ThomasVDD/SmartSoldering/Kicad_Tweezers/Dimensions.JPG

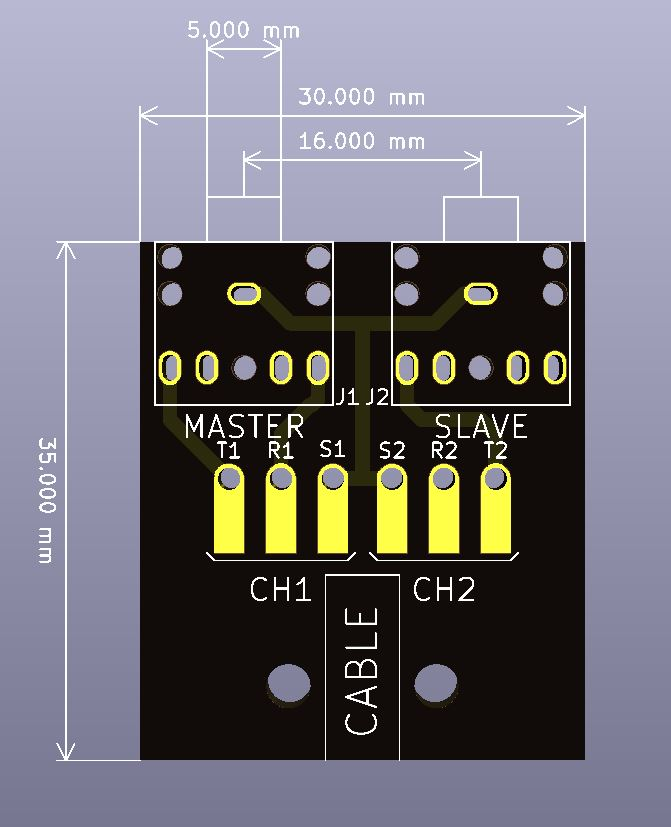
Kicad_Tweezers/Dimensions.JPG
