ThomasVDD/SmartSoldering/README.md

# SmartSoldering
SmartSoldering - Weller compatible soldering station
