ThomasVDD/SmartSoldering/Kicad/BOM.xlsx

Sheet: SolderingRT1Excell
Designator | Package | Quantity | Designation | manufacturer ref | farnell ref | digikey ref
J4 | PinHeader_1x08_P2.54mm_Vertical | 1 | Conn_01x08_Female |  |  | 2057-RS1-08-G-ND
SW4a1 | SW_Toggle_Blue_wSlots | 1 | SW_SPDT | ANT11SECQE |  | 2449-ANT11SECQE-ND
M2b1,QM4b1 | SOIC-8_3.9x4.9mm_P1.27mm | 2 | AO3400A | AOSP36326C |  | 785-AOSP36326CCT-ND
J1b1,J2b1 | Jack_3.5mm_CUI_SJ-3523-SMT_Horizontal | 2 | AudioJack3 | SJ-3523-SMT-TR |  | CP-3523SJCT-ND
J1b2,J2b2 | audio jack vertical | 2 | AudioJack3 | 0472570001 |  | WM17366-ND
U1c1 | TQFP-44_10x10mm_P0.8mm | 1 | ATmega32U4-AU | ATmega32U4-AU |  | ATMEGA32U4-AU-ND
C9a1,C14a1 | CP_Elec_8x10.5 | 2 | 330uF | EEE-1EA331UP |  | EEE-1EA331UP
Y1c1 | Crystal_SMD_3225-4Pin_3.2x2.5mm | 1 | 16MHz | TSX-3225 16.0000MF09Z-AC0 |  | SER4069CT-ND
U2a1 | SOT-89-3 | 1 | L78L05_SOT89 | L78L05ABUTR |  | 497-1181-1-ND
U1b1 | SOIC-8_3.9x4.9mm_P1.27mm | 1 | OPA2335 | OPA2335AIDR |  | 296-13462-1-ND
SW3a1,SW2a1 | SW_Push_1P1T_NO_6x6mm_H9.5mm | 2 | SW_Push | PTS645SK95SMTR92LFS |  | CKN10819CT-ND
SW1a1 | RotaryEncoder_Alps_EC11E-Switch_Vertical_H20mm | 1 | Rotary_Encoder_Switch | PEC11L-4115F-S0020 |  | PEC11L-4115F-S0020-ND
R9b1,R6a1,R3c1,R3a1,R2a1,R1a1,R18b1,R17a1,R13a1,R12a1,R11a1 | R_0603_1608Metric | 11 | 10k
R9a1,R8a1,R7b1,R7a1,R6b1,R5b1,R5a1,R4b1,R4a1,R18a1,R16b1,R15b1,R14b1,R13b1 | R_0603_1608Metric | 14 | 1k
R8b1,R17b1 | R_0603_1608Metric | 2 | 100
R5c1,R1b1,R10b1 | R_0603_1608Metric | 3 | 2k4
R4c1,R3b1,R12b1 | R_0603_1608Metric | 3 | 1M
R2c1,R1c1 | R_0603_1608Metric | 2 | 22
R2b1,R11b1 | R_0603_1608Metric | 2 | 56k
R14a1 | R_0603_1608Metric | 1 | 100k
R15a1 | R_1206_3216Metric | 1 | 1M
R10a1 | R_0805_2012Metric | 1 | 150
R16a1 | R_0603_1608Metric | 1 |  | CMFA3950104JNT |  | 317-1477-2-ND
P2c1 | PinHeader_2x03_P2.54mm_Vertical | 1 | Conn_02x03_Odd_Even
P1c1 | USB_Micro-B_Amphenol_10103594-0001LF_Horizontal | 1 | USB_B_Micro | 10104110-0001LF |  | 10103594-0001LF
P1a1 | BarrelJack_Wuerth_6941xx301002 | 1 | Barrel_Jack_Switch | 694106301002 |  | 732-5930-ND
NT1 | NetTie-2_SMD_Pad0.5mm | 1 | Net-Tie_2
M3b1,M1b1 | SOIC-8_3.9x4.9mm_P1.27mm | 2 | AO4407A | AO4407A |  | 785-1022-1-ND
J8a1,J7a1,J5a1,J4a1 | PinHeader_1x02_P2.54mm_Vertical | 4 | Conn_01x02_Male
J5 | PinHeader_1x04_P2.54mm_Vertical | 1 | Conn_01x04_Female |  |  | 2057-RS1-04-G-ND
D2b1,D1b1 | D_SMA | 2 | SS14 | SS14 |  | SS14CT-ND
D1c1 | LED_0603_1608Metric | 1 | LED | 150060GS75000 |  | 732-4971-1-ND
C9c1,C8c1,C7c1,C6c1,C5c1,C4b1,C1c1 | C_0603_1608Metric | 7 | 100nF
C8a1,C7b1,C7a1,C6b1,C6a1,C5a1,C4a1,C3b1,C3a1,C2b1,C2a1,C1a1,C11a1 | C_0603_1608Metric | 13 | 10nF | 0603B103K500CT |  | 1292-1386-1-ND
C5b1,C1b1 | C_1206_3216Metric | 2 | 10uF | CL31A106KAHNNNE |  | 1276-1075-2-ND
C4c1,C3c1 | C_0603_1608Metric | 2 | 22pF
C2c1,C13a1,C12a1 | C_0603_1608Metric | 3 | 1uF
J1 | wire to board connection | 1 |  |  |  | 277-1592-ND

Sheet: SolderingRT1
Id | Designator | Package | Quantity | Designation | Supplier and ref
1;"J4";"PinHeader_1x08_P2.54mm_Vertical";1;"Conn_01x08_Female";;;
2;"SW4a1";"SW_Toggle_Blue_wSlots";1;"SW_SPDT";;;
3;"M2b1 | QM4b1";"SOIC-8_3.9x4.9mm_P1.27mm";2;"AO3400A";;;
4;"J1b1 | J2b1 | J3";"Jack_3.5mm_CUI_SJ-3523-SMT_Horizontal";3;"AudioJack3";;;
5;"U1c1";"TQFP-44_10x10mm_P0.8mm";1;"ATmega32U4-AU";;;
6;"C9a1 | C14a1";"CP_Elec_8x10.5";2;"330uF";;;
7;"Y1c1";"Crystal_SMD_3225-4Pin_3.2x2.5mm";1;"16MHz";;;
8;"U2a1";"SOT-89-3";1;"L78L05_SOT89";;;
9;"U1b1";"SOIC-8_3.9x4.9mm_P1.27mm";1;"OPA2335";;;
10;"SW3a1 | SW2a1";"SW_Push_1P1T_NO_6x6mm_H9.5mm";2;"SW_Push";;;
11;"SW1a1";"RotaryEncoder_Alps_EC11E-Switch_Vertical_H20mm";1;"Rotary_Encoder_Switch";;;
12;"R9b1 | R6a1 | R3c1 | R3a1 | R2a1 | R1a1 | R18b1 | R17a1 | R13a1 | R12a1 | R11a1";"R_0603_1608Metric";11;"10k";;;
13;"R9a1 | R8a1 | R7b1 | R7a1 | R6b1 | R5b1 | R5a1 | R4b1 | R4a1 | R18a1 | R16b1 | R15b1 | R14b1 | R13b1";"R_0603_1608Metric";14;"1k";;;
14;"R8b1 | R17b1";"R_0603_1608Metric";2;"100";;;
15;"R5c1 | R1b1 | R10b1";"R_0603_1608Metric";3;"2k4";;;
16;"R4c1 | R3b1 | R12b1";"R_0603_1608Metric";3;"1M";;;
17;"R2c1 | R1c1";"R_0603_1608Metric";2;"22";;;
18;"R2b1 | R11b1";"R_0603_1608Metric";2;"56k";;;
19;"R16a1 | R14a1";"R_0603_1608Metric";2;"100k";;;
20;"R15a1";"R_1206_3216Metric";1;"1M";;;
21;"R10a1";"R_0805_2012Metric";1;"150";;;
22;"P2c1";"PinHeader_2x03_P2.54mm_Vertical";1;"Conn_02x03_Odd_Even";;;
23;"P1c1";"USB_Micro-B_Amphenol_10103594-0001LF_Horizontal";1;"USB_B_Micro";;;
24;"P1a1";"BarrelJack_Wuerth_6941xx301002";1;"Barrel_Jack_Switch";;;
25;"NT1";"NetTie-2_SMD_Pad0.5mm";1;"Net-Tie_2";;;
26;"M3b1 | M1b1";"SOIC-8_3.9x4.9mm_P1.27mm";2;"AO4407A";;;
27;"J8a1 | J7a1 | J5a1 | J4a1";"PinHeader_1x02_P2.54mm_Vertical";4;"Conn_01x02_Male";;;
28;"J5";"PinHeader_1x04_P2.54mm_Vertical";1;"Conn_01x04_Female";;;
29;"D2b1 | D1b1";"D_SMA";2;"SS14";;;
30;"D1c1";"LED_0603_1608Metric";1;"LED";;;
31;"C9c1 | C8c1 | C7c1 | C6c1 | C5c1 | C4b1 | C1c1";"C_0603_1608Metric";7;"100nF";;;
32;"C8a1 | C7b1 | C7a1 | C6b1 | C6a1 | C5a1 | C4a1 | C3b1 | C3a1 | C2b1 | C2a1 | C1a1 | C11a1";"C_0603_1608Metric";13;"10nF";;;
33;"C5b1 | C1b1";"C_1206_3216Metric";2;"10uF";;;
34;"C4c1 | C3c1";"C_0603_1608Metric";2;"22pF";;;
35;"C2c1 | C13a1 | C12a1";"C_0603_1608Metric";3;"1uF";;;
