ThomasVDD/SmartSoldering/Case/Stand_tweezers_solo.stl

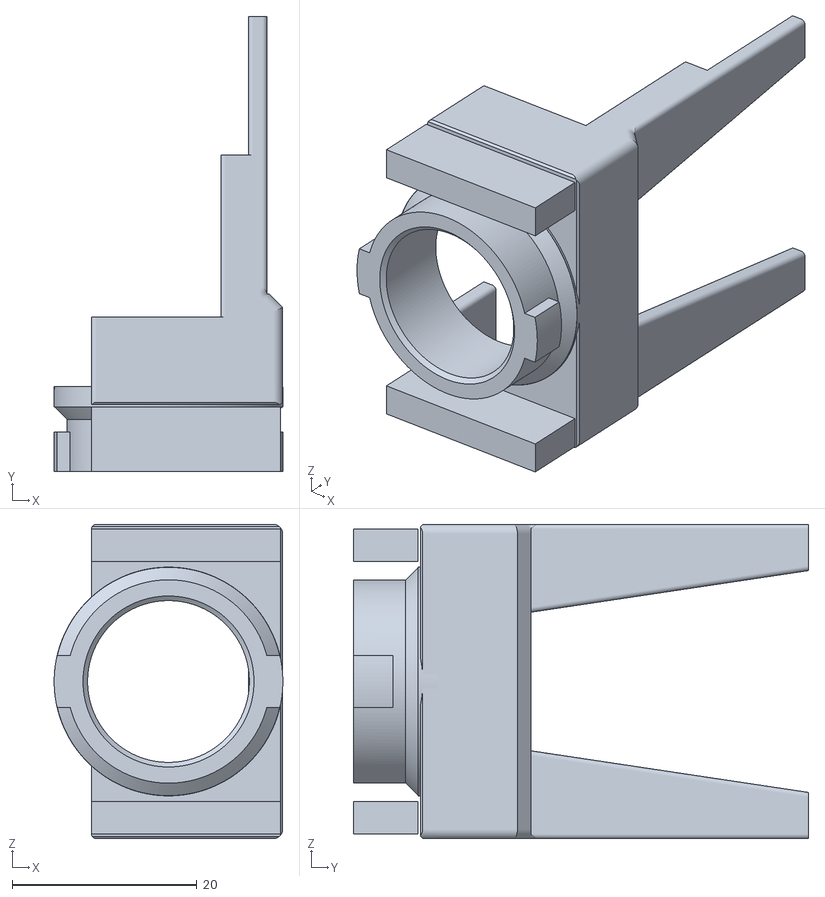
[picture p2: CAD file, 2021-01-05]
Case/Stand_tweezers_solo.stl
24.8 x 49.2 x 34.0
