ThomasVDD/SmartSoldering/Kicad/Tip.dxf

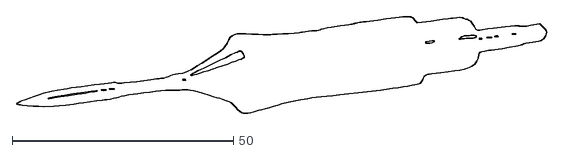
[picture p3: CAD file, 2021-01-05]
Kicad/Tip.dxf
119.8 x 22.0
