ThomasVDD/SmartSoldering/Case/Stand_Tip.stl

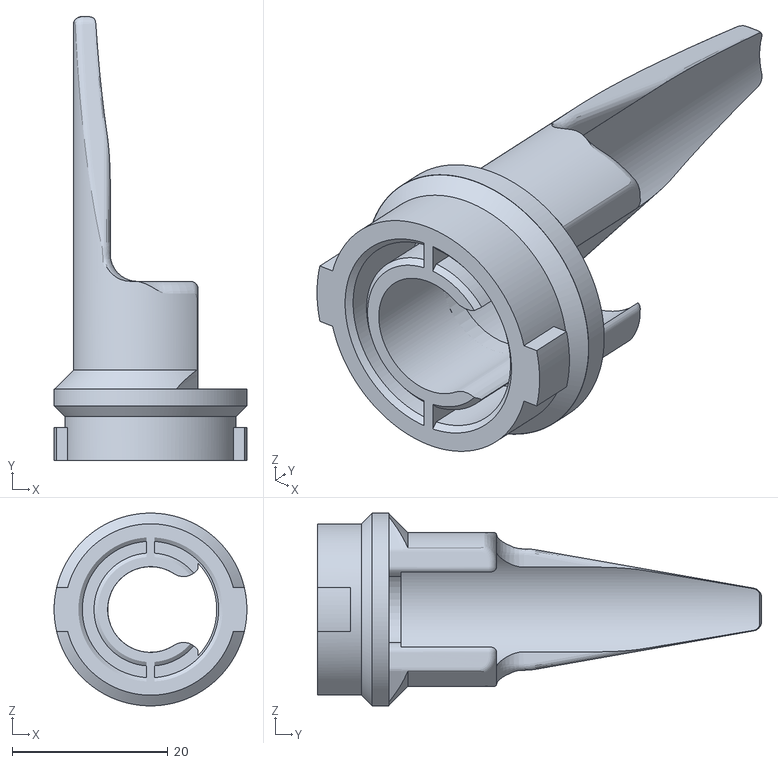
[picture p4: CAD file, 2021-01-05]
Case/Stand_Tip.stl
24.8 x 57.0 x 24.7
