ThomasVDD/SmartSoldering/Kicad/Toggle_SW_Blue_R0.step

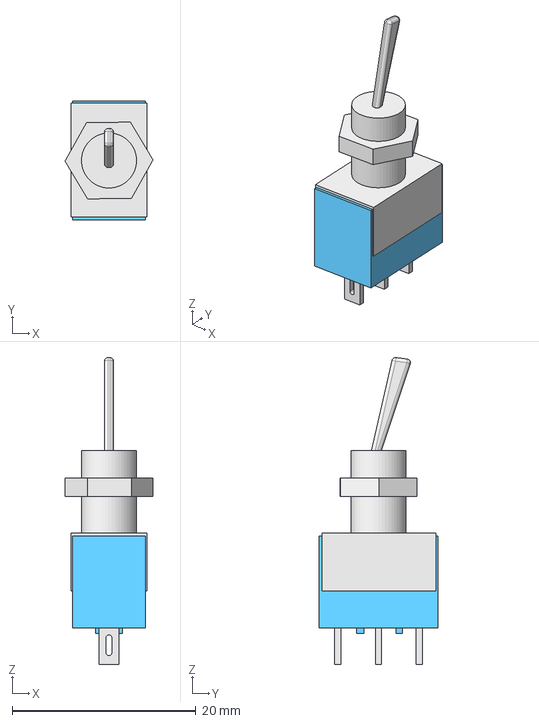
[picture p5: CAD file, 2021-01-05]
Kicad/Toggle_SW_Blue_R0.step
9.58 x 13.0 x 33.4 mm
Housing
Chrome
