ThomasVDD/SmartSoldering/Case/Frontpanel_V4.stl

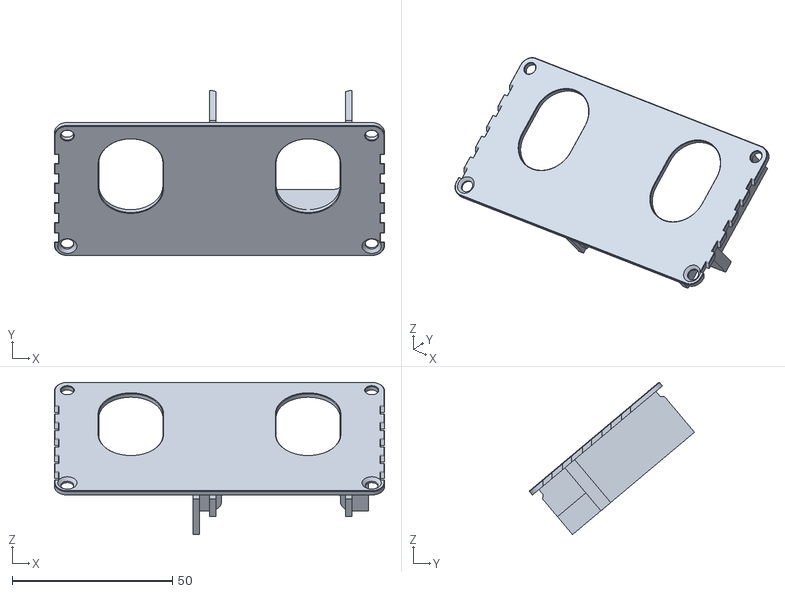
[picture p6: CAD file, 2021-01-05]
Case/Frontpanel_V4.stl
103.0 x 51.5 x 47.5
