ThomasVDD/SmartSoldering/Kicad/Polarity_marking_center_positive (1).dxf

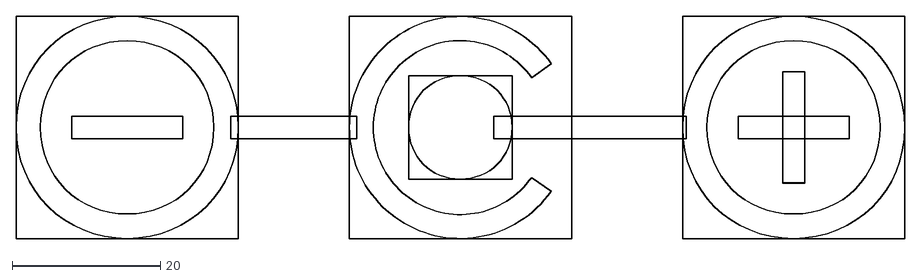
[picture p7: CAD file, 2021-01-05]
Kicad/Polarity_marking_center_positive (1).dxf
120.0 x 30.0
