ThomasVDD/SmartSoldering/Case/LCD_cover_V5_buttons.stl

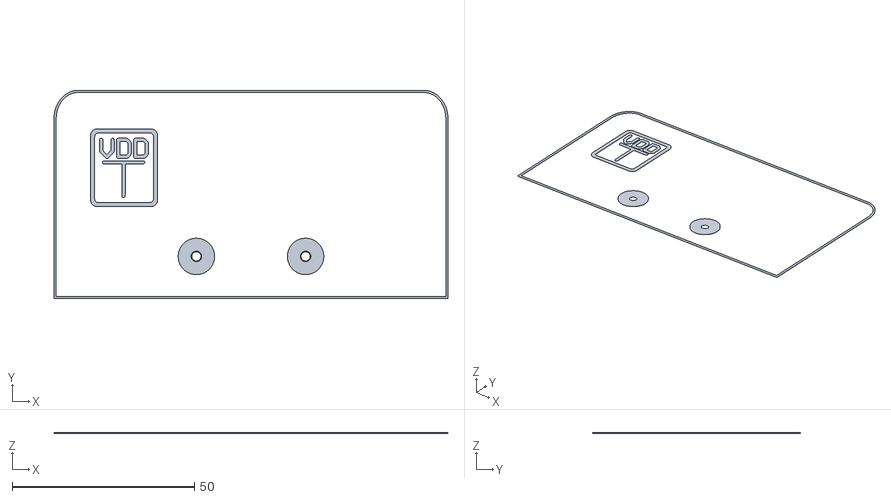
[picture p8: CAD file, 2021-01-05]
Case/LCD_cover_V5_buttons.stl
108.2 x 57.2 x 0.3
