ThomasVDD/SmartSoldering/Case/LCD_cover_V5.stl

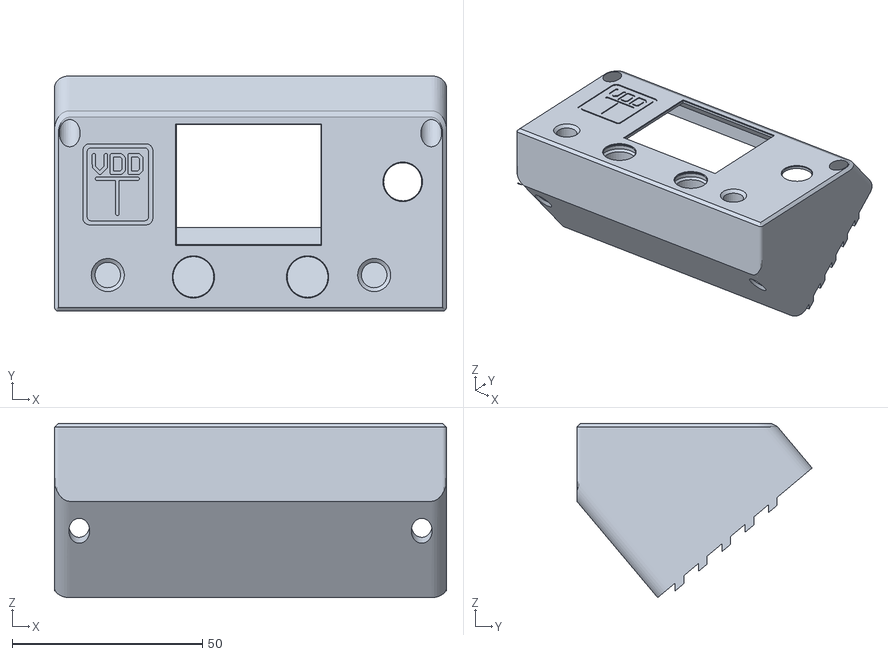
[picture p9: CAD file, 2021-01-05]
Case/LCD_cover_V5.stl
103.0 x 61.8 x 45.8
