ThomasVDD/SmartSoldering/Case/Tweezers_V2_partB.stl

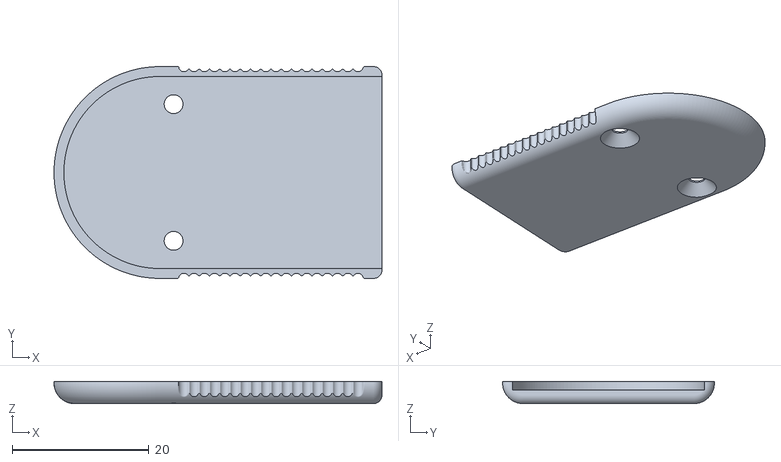
[picture p10: CAD file, 2021-01-05]
Case/Tweezers_V2_partB.stl
48.0 x 31.0 x 3.25
