ThomasVDD/SmartSoldering/Case/Tweezers_V2_partD.stl

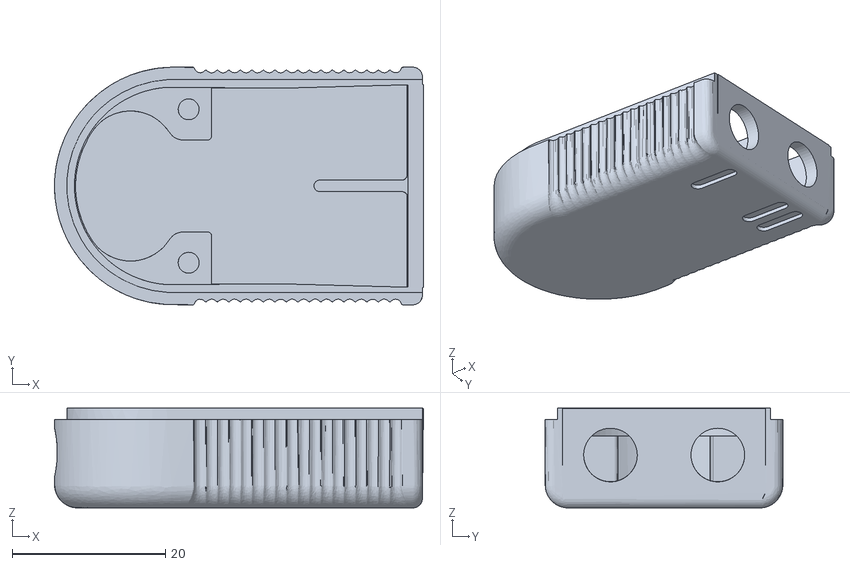
[picture p11: CAD file, 2021-01-05]
Case/Tweezers_V2_partD.stl
48.1 x 31.0 x 13.0
