ThomasVDD/SmartSoldering/Case/Tweezers_V2_partC.stl

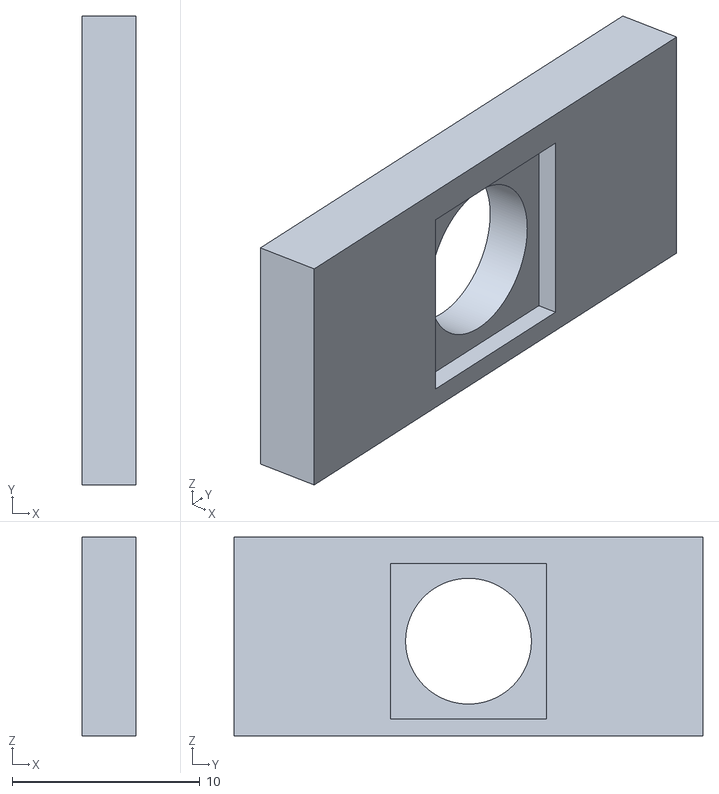
[picture p12: CAD file, 2021-01-05]
Case/Tweezers_V2_partC.stl
2.90 x 25.0 x 10.6
