ThomasVDD/SmartSoldering/Case/Stand_tweezers.stl

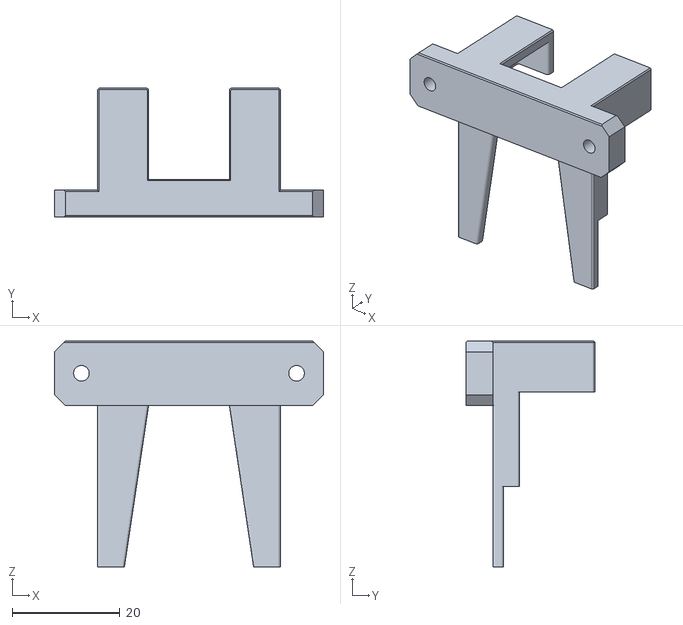
[picture p13: CAD file, 2021-01-05]
Case/Stand_tweezers.stl
50.0 x 24.0 x 42.0
