ThomasVDD/SmartSoldering/Case/Knob_V4.stl

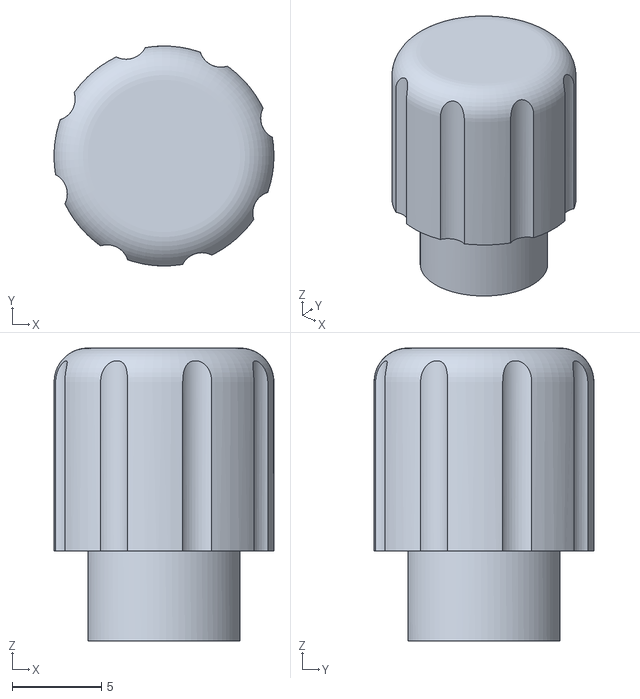
[picture p14: CAD file, 2021-01-05]
Case/Knob_V4.stl
12.3 x 12.3 x 16.5
