ThomasVDD/SmartSoldering/Case/Handle_fine.stl

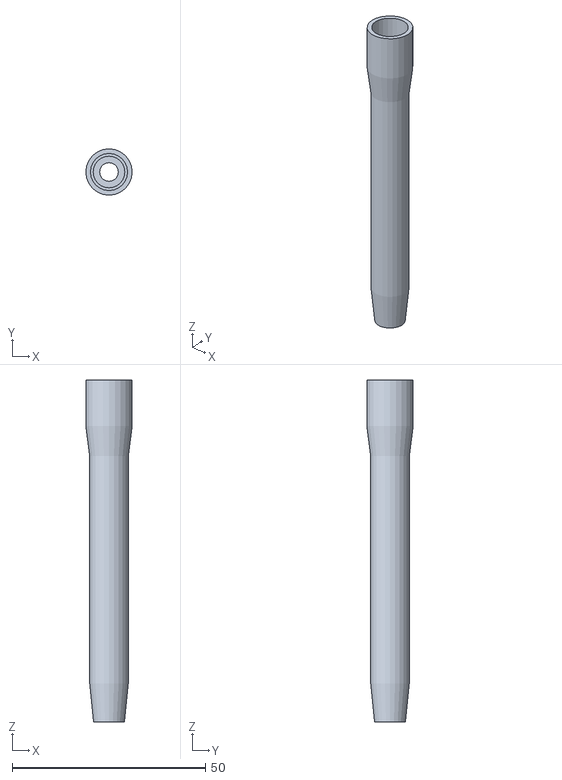
[picture p15: CAD file, 2021-01-05]
Case/Handle_fine.stl
12.0 x 12.0 x 88.5
