ThomasVDD/SmartSoldering/Case/Handle_V5.stl

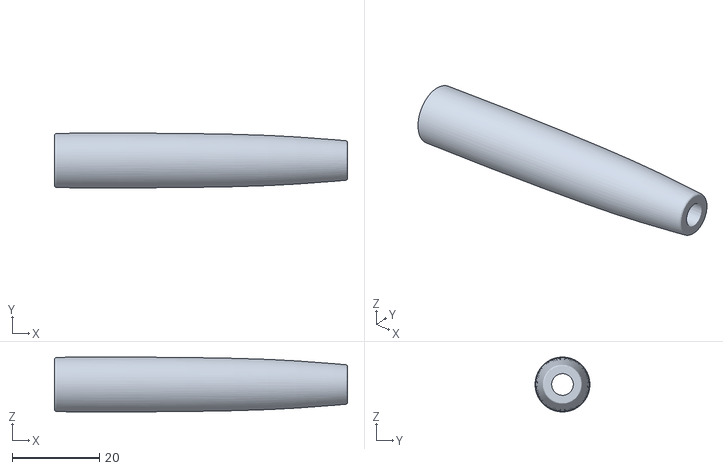
[picture p16: CAD file, 2021-01-05]
Case/Handle_V5.stl
67.3 x 12.6 x 12.6
