ThomasVDD/SmartSoldering/Case/Frontpanel_V5_nobezel.stl

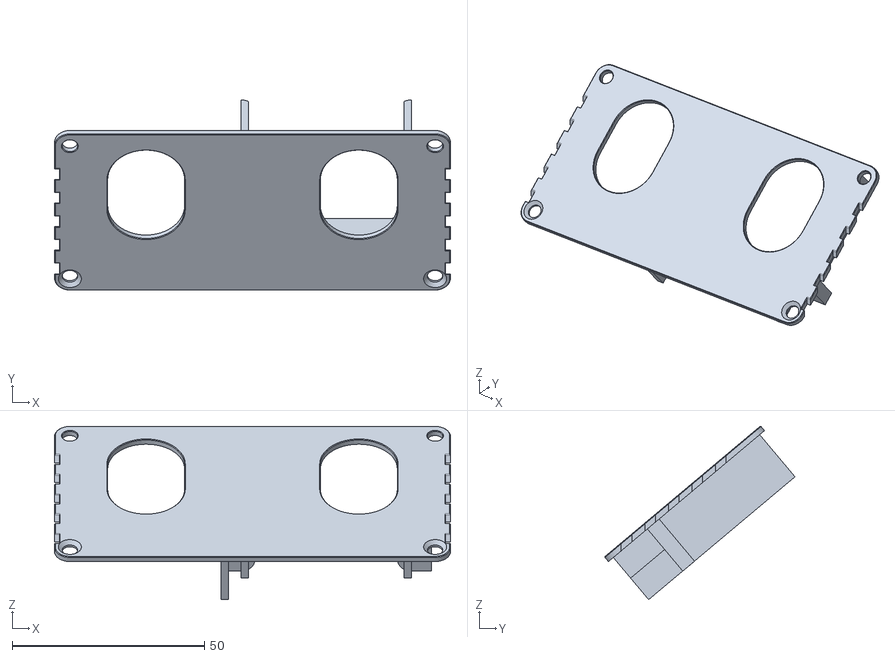
[picture p17: CAD file, 2021-01-05]
Case/Frontpanel_V5_nobezel.stl
103.0 x 49.4 x 45.1
