ThomasVDD/SmartSoldering/Case/Stand_aliexpress_tip.stl

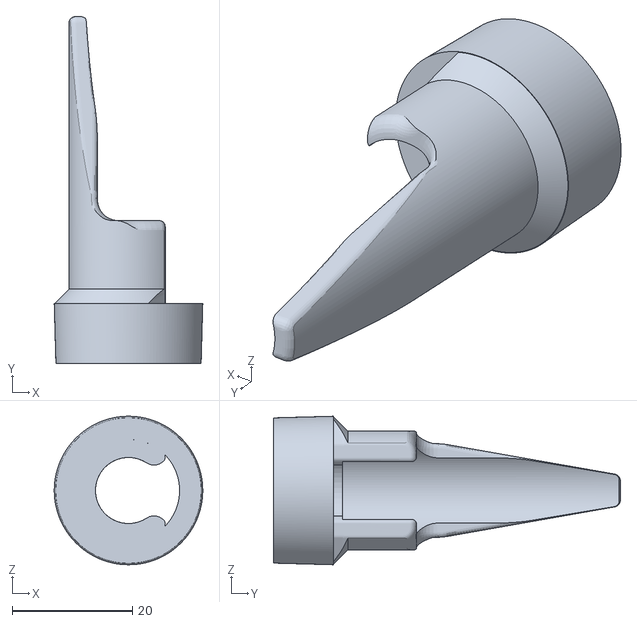
[picture p18: CAD file, 2021-01-05]
Case/Stand_aliexpress_tip.stl
24.7 x 57.8 x 24.7
