ThomasVDD/SmartSoldering/Case/Stand_Tensioner.stl

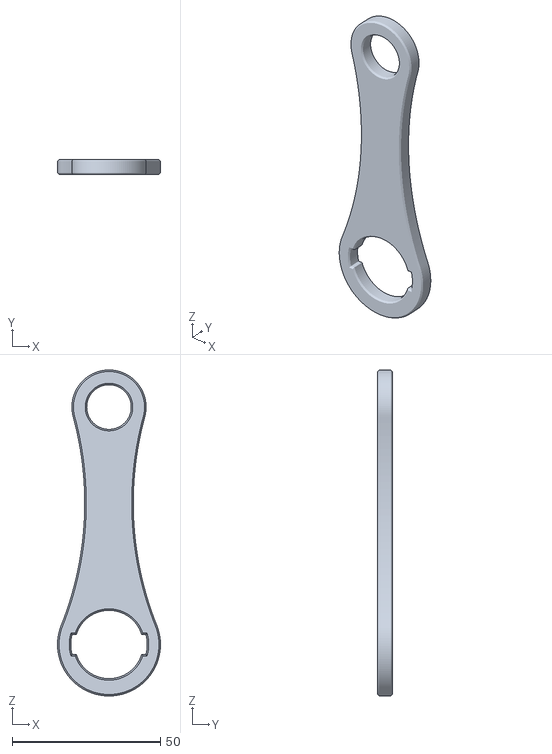
[picture p19: CAD file, 2021-01-05]
Case/Stand_Tensioner.stl
34.7 x 5.00 x 109.8
