ThomasVDD/SmartSoldering/(list of files, cad)

Other CAD files:
Case/Backpanel_V4.stl
Case/Backpanel_V5_nobezel.stl
Case/Handle_V2.stl
Case/Handle_V3.stl
Case/Handle_V4.stl
Case/Knob_V2.stl
Case/Old versions/Backpanel_V1.stl
Case/Old versions/Backpanel_V2.stl
Case/Old versions/Backpanel_V3.stl
Case/Old versions/Captive button v1.stl
Case/Old versions/Captive button v20.stl
Case/Old versions/Frontpanel_V1.stl
Case/Old versions/Frontpanel_V2.stl
Case/Old versions/Frontpanel_V3.stl
Case/Old versions/Handle.stl
Case/Old versions/Knob_V1.stl
Case/Old versions/LCD_cover_V1.stl
Case/Old versions/LCD_cover_V2.stl
Case/Old versions/LCD_cover_V4.stl
Case/Old versions/LCD_cover_V4_buttons.stl
Case/Tweezers_V1_partD.stl
