ThomasVDD/SmartSoldering/Kicad_Tweezers/Kicad_Tweezers.kicad_pcb

## KiCad design Kicad_Tweezers/Kicad_Tweezers.kicad_pcb (2021-01-05)

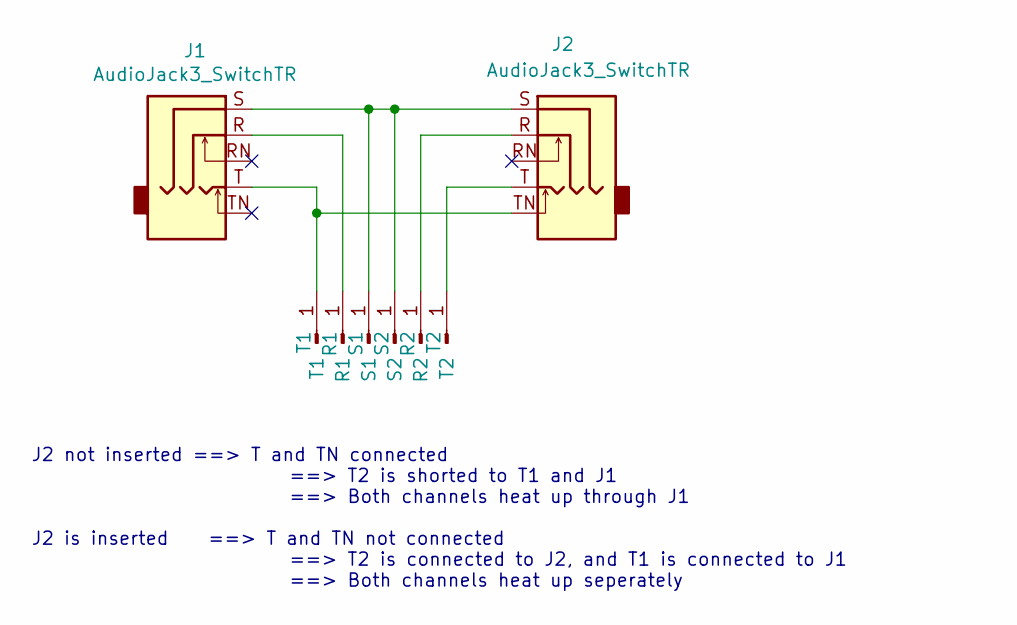
[picture p23: schematic Kicad_Tweezers.sch]

Parts:
J1, J2: AudioJack3_SwitchTR; Audiojack3_SwitchTR
R1: R1; Audiojack_pad
R2: R2; Audiojack_pad
S1: S1; Audiojack_pad
S2: S2; Audiojack_pad
T1: T1; Audiojack_pad
T2: T2; Audiojack_pad

Connections:
unnamed: J1.R, R1.1
unnamed: J1.S, J2.S, S1.1, S2.1
unnamed: J1.T, J2.TN, T1.1
unnamed: J2.R, R2.1
unnamed: J2.T, T2.1

Notes on the sheet:
J2 not inserted ==> T and TN connected ==> T2 is shorted to T1 and J1 ==> Both channels heat up through J1 J2 is inserted ==> T and TN not connected ==> T2 is connected to J2, and T1 is connected to J1 ==> Both channels heat up seperately

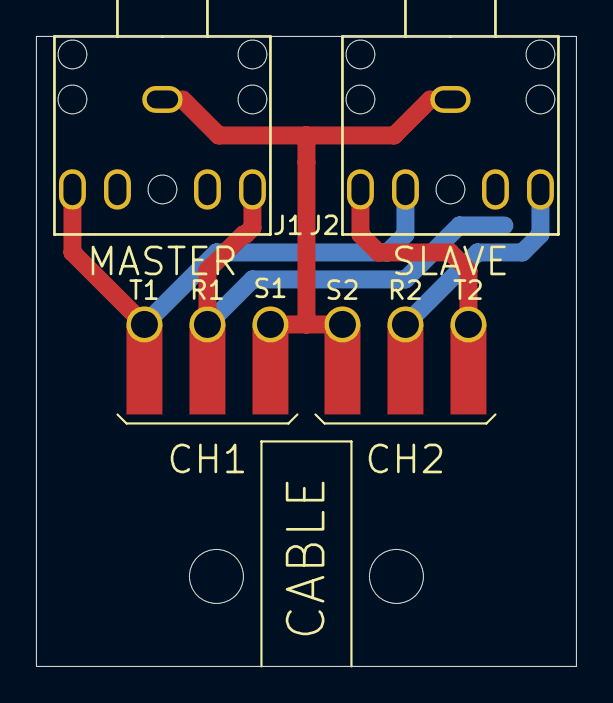
[picture p24: board Kicad_Tweezers.kicad_pcb from above]

Board: 2 copper layers, 30.0 x 35.0 mm, 8 parts (0 on the bottom side), 5 nets.
