ThomasVDD/SmartSoldering/Kicad/SolderingRT1.kicad_pcb

## KiCad design Kicad/SolderingRT1.kicad_pcb (2021-01-05)

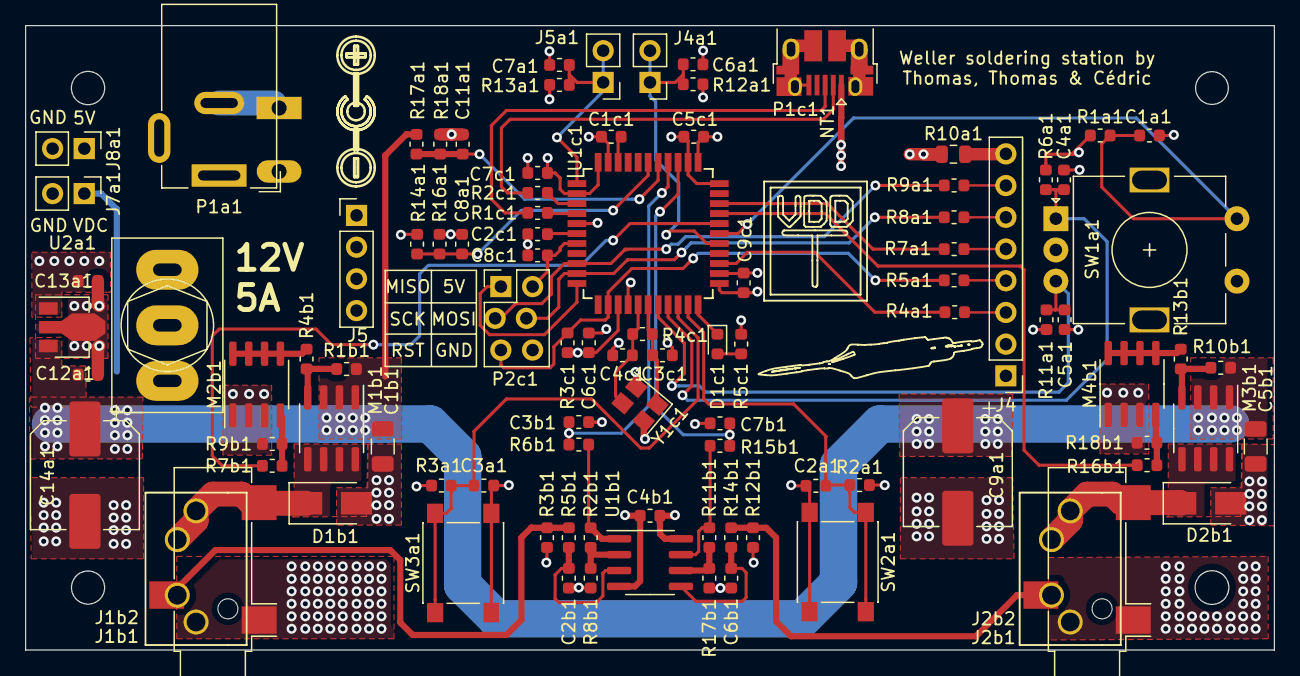
[picture p25: board SolderingRT1.kicad_pcb from above]

Board: 4 copper layers, 100.0 x 50.0 mm, 99 parts (1 on the bottom side), 56 nets.

Parts:
C1a1, C2a1, C2b1, C3a1, C3b1, C4a1, C5a1, C6a1, C6b1, C7a1, C7b1, C8a1, C11a1: 10nF; C_0603_1608Metric
C1b1, C5b1: 10uF; C_1206_3216Metric
C1c1, C4b1, C5c1, C6c1, C7c1, C8c1, C9c1: 100nF; C_0603_1608Metric
C2c1, C12a1, C13a1: 1uF; C_0603_1608Metric
C3c1, C4c1: 22pF; C_0603_1608Metric
C9a1, C14a1: 330uF; CP_Elec_8x10.5
D1b1, D2b1: SS14; D_SMA
D1c1: LED; LED_0603_1608Metric
J1: Screw_Terminal_01x02; PhoenixContact_MC-G_02x5.08mm_Angled
J1b1, J2b1: AudioJack3; Jack_3.5mm_CUI_SJ-3523-SMT_Horizontal
J1b2, J2b2: AudioJack3; Audiojack_straight
J4: Conn_01x08_Female; PinHeader_1x08_P2.54mm_Vertical
J4a1, J5a1, J7a1, J8a1: Conn_01x02_Male; PinHeader_1x02_P2.54mm_Vertical
J5: Conn_01x04_Female; PinHeader_1x04_P2.54mm_Vertical
M1b1, M3b1: AO4407A; SOIC-8_3.9x4.9mm_P1.27mm
M2b1, M4b1: AOSP36326C; SOIC-8_3.9x4.9mm_P1.27mm
NT1: Net-Tie_2; NetTie-2_SMD_Pad0.5mm
P1a1: Barrel_Jack_Switch; BarrelJack_Wuerth_6941xx301002
P1c1: USB_B_Micro; USB_Micro-B_Amphenol_10103594-0001LF_Horizontal
P2c1: Conn_02x03_Odd_Even; PinHeader_2x03_P2.54mm_Vertical
R1a1, R2a1, R3a1, R3c1, R6a1, R9b1, R11a1, R12a1, R13a1, R17a1, R18b1: 10k; R_0603_1608Metric
R1b1, R5c1, R10b1: 2k4; R_0603_1608Metric
R1c1, R2c1: 22; R_0603_1608Metric
R2b1, R11b1: 56k; R_0603_1608Metric
R3b1, R4c1, R12b1: 1M; R_0603_1608Metric
R4a1, R4b1, R5a1, R5b1, R6b1, R7a1, R7b1, R8a1, R9a1, R13b1, R14b1, R15b1, R16b1, R18a1: 1k; R_0603_1608Metric
R8b1, R17b1: 100; R_0603_1608Metric
R10a1: 150; R_0805_2012Metric
R14a1, R16a1: 100k; R_0603_1608Metric
SW1a1: Rotary_Encoder_Switch; RotaryEncoder_Alps_EC11E-Switch_Vertical_H20mm
SW2a1, SW3a1: SW_Push; SW_Push_1P1T_NO_6x6mm_H9.5mm
SW4a1: SW_SPDT; SW_Toggle_Blue_wSlots
U1b1: OPA2335; SOIC-8_3.9x4.9mm_P1.27mm
U1c1: ATmega32U4-AU; TQFP-44_10x10mm_P0.8mm
U2a1: L78L05_SOT89; SOT-89-3
Y1c1: 16MHz; Crystal_SMD_3225-4Pin_3.2x2.5mm

Connections:
+5V: C4b1.1, C5c1.1, C6c1.1, C7c1.1, C8c1.1, C9c1.1, C13a1.1, J4.1, J8a1.1, NT1.2, P2c1.2, R1a1.2, R2a1.2, R3a1.2, R3b1.2, R3c1.2, R5c1.2, R6a1.2, R10a1.1, R11a1.2, R12a1.2, R12b1.2, R13a1.2, R14a1.2, U1b1.8, U1c1.2, U1c1.7, U1c1.14, U1c1.24, U1c1.34, U1c1.44, U2a1.1
+VDC: C1b1.1, C5b1.1, C9a1.1, C12a1.1, C14a1.1, J7a1.1, M1b1.1, M1b1.2, M1b1.3, M3b1.1, M3b1.2, M3b1.3, R1b1.2, R10b1.2, R17a1.2, SW4a1.3, U2a1.3
/A0-DC: R7a1.1, U1c1.31
/CS: R4a1.1, U1c1.25
/Channels/Temp1: J1b1.R, J1b2.R, R3b1.1, R5b1.2
/Channels/Temp2: J2b1.R, J2b2.R, R12b1.1, R14b1.2
/EncoderA: C4a1.1, R6a1.1, SW1a1.A, U1c1.19
/EncoderB: C5a1.1, R11a1.1, SW1a1.B, U1c1.18
/EncoderSW: C1a1.1, R1a1.1, SW1a1.S2, U1c1.28
/Heater1: R7b1.2, U1c1.29
/Heater2: R16b1.2, U1c1.30
/MOSI-SDA: P2c1.4, R8a1.1, U1c1.10
/Micro/D14-MISO: P2c1.1, U1c1.11
/Micro/GreenLED: D1c1.1, U1c1.22
/NTCtemp1: C8a1.1, R14a1.1, R16a1.1, U1c1.39
/RST: P2c1.5, R3c1.1, R5a1.1, U1c1.13
/RestHeater1: C6a1.1, J4a1.1, J4a1.2, R12a1.1, U1c1.27
/RestHeater2: C7a1.1, J5a1.1, J5a1.2, R13a1.1, U1c1.1
/SCK: P2c1.3, R9a1.1, U1c1.9
/SW1: C2a1.1, R2a1.1, SW2a1.1, U1c1.21
/SW2: C3a1.1, R3a1.1, SW3a1.1, U1c1.20
/Vdcin: C11a1.1, R17a1.1, R18a1.2, U1c1.38
/Vtemp1: C3b1.1, R6b1.1, U1c1.37
/Vtemp2: C7b1.1, R15b1.1, U1c1.36
GND: C1a1.2, C1b1.2, C1c1.2, C2a1.2, C2b1.2, C2c1.2, C3a1.2, C3b1.2, C3c1.1, C4a1.2, C4b1.2, C4c1.1, C5a1.2, C5b1.2, C5c1.2, C6a1.2, C6b1.2, C6c1.2, C7a1.2, C7b1.2, C7c1.2, C8a1.2, C8c1.2, C9a1.2, C9c1.2, C11a1.2, C12a1.2, C13a1.2, C14a1.2, D1b1.2, D2b1.2, J1.1, J1b1.S, J1b2.S, J2b1.S, J2b2.S, J4.2, J7a1.2, J8a1.2, M2b1.1, M2b1.2, M2b1.3, M4b1.1, M4b1.2, M4b1.3, P1a1.2, P1a1.3, P1c1.5, P1c1.6, P2c1.6, R8b1.1, R9b1.1, R16a1.2, R17b1.1, R18a1.1, R18b1.1, SW1a1.C, SW1a1.S1, SW2a1.2, SW3a1.2, U1b1.4, U1c1.5, U1c1.15, U1c1.23, U1c1.33, U1c1.35, U1c1.43, U2a1.2, Y1c1.2, Y1c1.4
unnamed: C1c1.1, U1c1.42
unnamed: C2b1.1, R5b1.1, U1b1.3
unnamed: C2c1.1, U1c1.6
unnamed: C3c1.2, R4c1.2, U1c1.17, Y1c1.1
unnamed: C4c1.2, R4c1.1, U1c1.16, Y1c1.3
unnamed: C6b1.1, R14b1.1, U1b1.5
unnamed: D1b1.1, J1b1.T, J1b2.T, M1b1.5, M1b1.6, M1b1.7, M1b1.8
unnamed: D1c1.2, R5c1.1
unnamed: D2b1.1, J2b1.T, J2b2.T, M3b1.5, M3b1.6, M3b1.7, M3b1.8
unnamed: J1.2, P1a1.1, SW4a1.1, SW4a1.2
unnamed: J4.3, R4a1.2
unnamed: J4.4, R5a1.2
unnamed: J4.5, R7a1.2
unnamed: J4.6, R8a1.2
unnamed: J4.7, R9a1.2
unnamed: J4.8, R10a1.2
unnamed: M1b1.4, R1b1.1, R4b1.2
unnamed: M2b1.4, R7b1.1, R9b1.2
unnamed: M2b1.5, M2b1.6, M2b1.7, M2b1.8, R4b1.1
unnamed: M3b1.4, R10b1.1, R13b1.2
unnamed: M4b1.4, R16b1.1, R18b1.2
unnamed: M4b1.5, M4b1.6, M4b1.7, M4b1.8, R13b1.1
unnamed: NT1.1, P1c1.1
unnamed: P1c1.2, R2c1.1
unnamed: P1c1.3, R1c1.1
unnamed: R1c1.2, U1c1.4
unnamed: R2b1.1, R6b1.2, U1b1.1
unnamed: R2b1.2, R8b1.2, U1b1.2
unnamed: R2c1.2, U1c1.3
unnamed: R11b1.1, R15b1.2, U1b1.7
unnamed: R11b1.2, R17b1.2, U1b1.6
