ThomasVDD/SmartSoldering/(commit log)

2021-01-05 Added STLs
    [Backpanel_V1.stl, Backpanel_V2.stl, Backpanel_V3.stl, Backpanel_V4.stl, Backpanel_V5_nobezel.stl, Captive button v1.stl, Captive button v20.stl, Frontpanel_V1.stl]
2021-01-05 Added PCB and Code
    [BOM.csv, BOM.xlsx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]
